byhabibi/d01e-roaster/pcb/schematics/INDEX.html

# D01E — Junior PCB: L0 → L3 (kelas industri)

Semua SVG · tanpa PDF · buka di browser

Urutan: L0 blueprint → L1 zona → L2 pad → L3 aturan produksi (layer/track/via/keepout/GND) → KiCad DRC 0 → Gerber baru

### L0 Engineering Blueprint

L0 · BLUEPRINT

## System Architecture

Power · control · SPI/I2C/UART · J9 · NET

### L1 Konsep

L1

## MAIN blok

Zona module seats

L1

## IO blok

PSU K1 SSR MOSFET

### L2 Layout

L2

## DevKit pin → net

L/R pad map

L2

## Checklist pad→pad

Route list

L2

## Placement zones

Di mana komponen

L2

## IO pad→pad

AC/PSU/beban

### L3 Manufacturing (wajib industri)

L3 · 1

## NET DEFINITION

Type · V · Dir · Active

L3 · 2

## LAYER · TRACK · VIA

Stackup · lebar · via

L3 · 3

## ROUTING PRIORITY

Urutan 1→8

L3 · 4

## DO NOT / SEJAJAR

Larangan keras

L3 · 5

## ORIENTATION

USB · Pin1 · latch

L3 · 6

## KEEPOUT + ASSEMBLY

Antena 15 mm · buck

L3 · 11

## PROXIMITY

Harus dekat · boleh jauh

L3 · 12

## GND STRATEGY

Pour · PE · analog

L3 · 13

## FINAL CHECKLIST

12V→…→Silk

L3 · 7

## GERBER CHECKLIST

Sebelum zip pabrik

L3 · 8

## FAB NOTES

FR4 1.6 1oz HASL

L3 · 9

## BOM LOCK

FIXED 5V · LC1D25JD

L3 · 10

## COMMON MISTAKES

SALAH vs BENAR

Net levels terkunci firmware: HEATER/DRUM Active HIGH · COOL Active LOW · tombol Active LOW · ESTOP HIGH=unsafe.
Route order: +12V → +5V → GND → SPI → TC → UART → GPIO → Silk (L3_13).
Jangan kirim Gerber WROOM lama.
