byhabibi/d01e-roaster/firmware/include/settings_storage.h

#pragma once
#include <Arduino.h>

void settingsBegin();
bool settingsGetUseFahrenheit();
void settingsSetUseFahrenheit(bool fahrenheit);
uint32_t settingsGetBatchCount();
void settingsIncrementBatch();
void settingsFormatBatch(char *out, size_t len);
