byhabibi/d01e-roaster/(commit log)

2026-10-22 Publish the D01E electric roaster controller and its two-board PCB set.
    [D01E-IO-PWR-B_Cu.gbl, D01E-IO-PWR-B_Mask.gbs, D01E-IO-PWR-B_Paste.gbp, D01E-IO-PWR-B_Silkscreen.gbo, D01E-IO-PWR-Edge_Cuts.gm1, D01E-IO-PWR-F_Cu.gtl, D01E-IO-PWR-F_Mask.gts, D01E-IO-PWR-F_Paste.gtp]
2026-10-22 Add cropped mainboard views of the routed D01E control PCB.
